andkuc/k-comp/(commit log)

2026-06-17 K-CompV2, docs, examples, gerber, libs
2026-06-25 Add echo timeout to distance sensor
    pulseIn() without a timeout blocks for the default ~1s when no echo
    returns (object out of range or sensor unplugged), which freezes the
    program loop. Pass a 25ms timeout (~4m, covers the HC-SR04's full range).
    Return value is unchanged: 0 on no echo, just without the long block.
2026-10-14 printInt, printDouble documented.
